benwys/PCB-kondycjonowanie/README.md

# PCB-kondycjonowanie
Projekt układu kondycjonowania sygnałów pomiarowych dla falownika napięcia
