benwys/PCB-kondycjonowanie/331811.brd

## EAGLE design 331811.brd (2026-05-14)

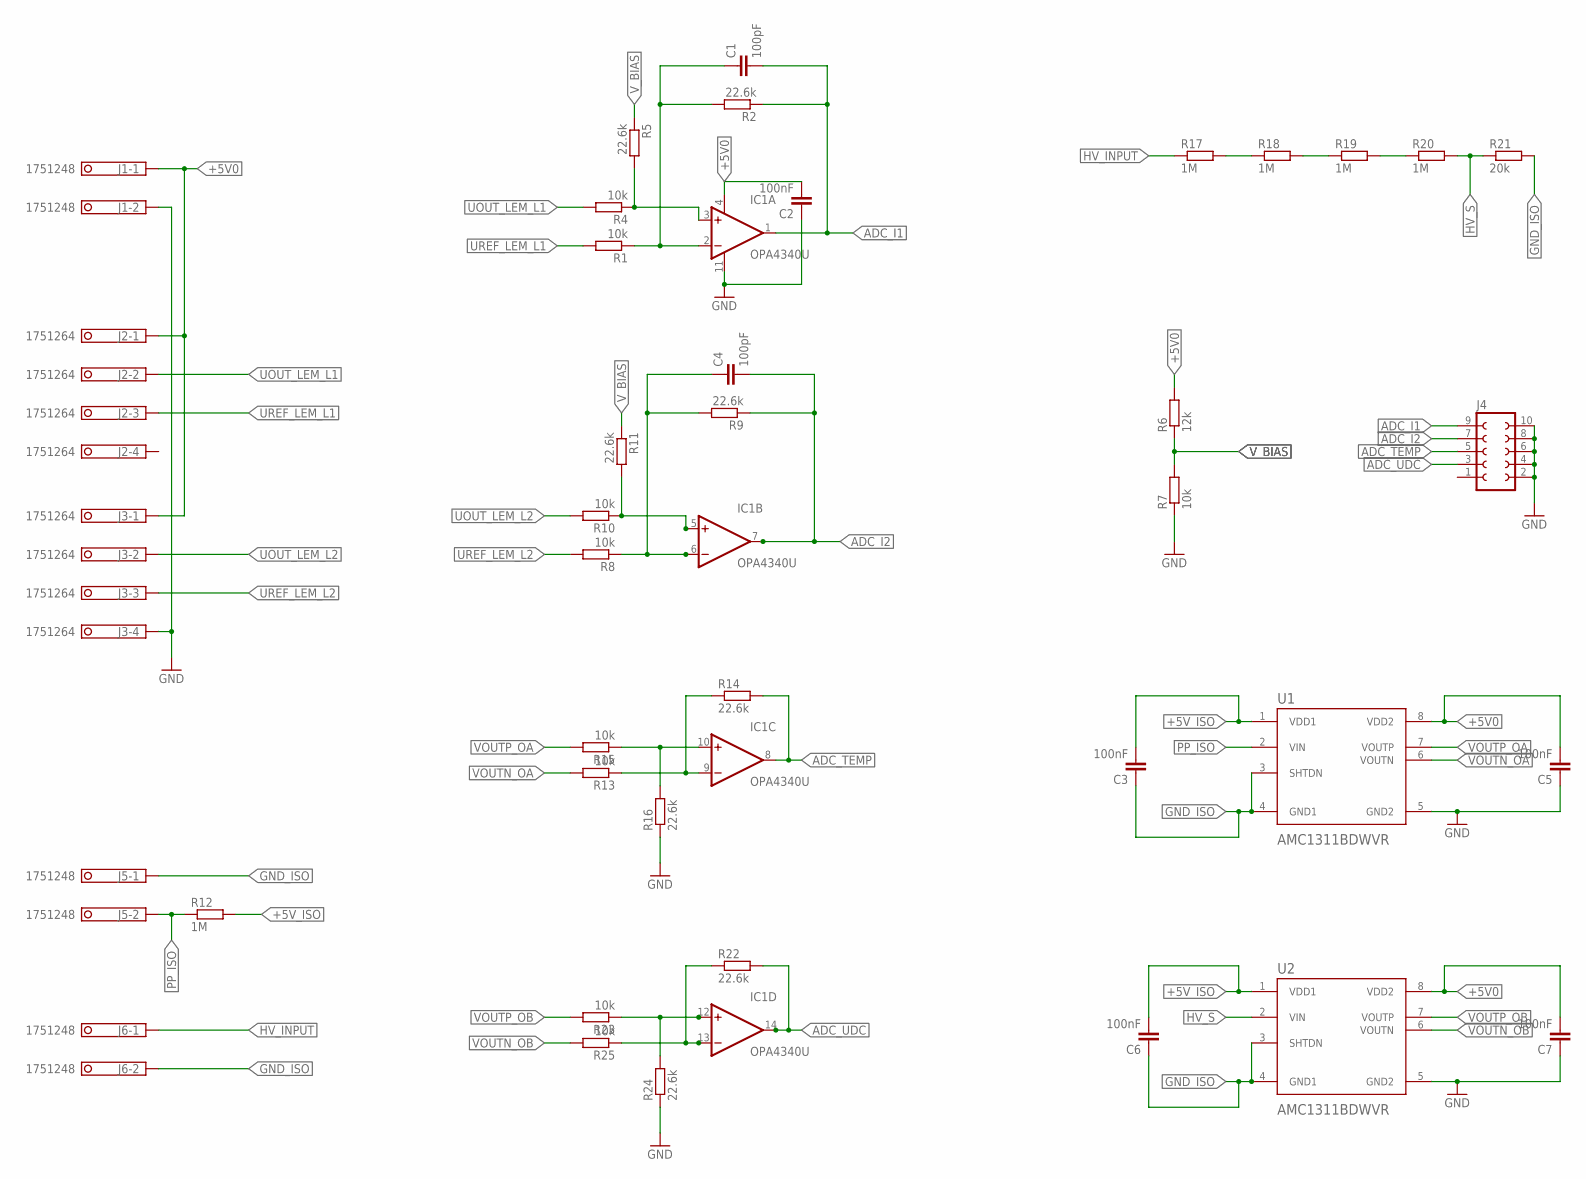
[picture p8: schematic 331811.sch]

Parts:
C1, C4: 100pF; C0805
C2, C3, C5, C6, C7: 100nF; C0805
IC1: OPA4340U; SO14
J1, J5, J6: 1751248
J2, J3: 1751264
J4: FE05-2
R1, R4, R7, R8, R10, R13, R15, R23, R25: 10k; M1206
R2, R5, R9, R11, R14, R16, R22, R24: 22.6k; M1206
R6: 12k; M1206
R12, R17, R18, R19, R20: 1M; M1206
R21: 20k; M1206
U1, U2: AMC1311BDWVR; SOIC127P1150X280-8N

Connections:
+5V0: C2.2, C5.2, C7.2, IC1.4 (V+), J1.1, J2.1, J3.1, R6.2, U1.8 (VDD2), U2.8 (VDD2)
+5V_ISO: C3.2, C6.2, R12.2, U1.1 (VDD1), U2.1 (VDD1)
ADC_I1: C1.2, IC1.1 (OUT), J4.9, R2.1
ADC_I2: C4.2, IC1.7 (OUT), J4.7, R9.1
ADC_TEMP: IC1.8 (OUT), J4.5, R14.2
ADC_UDC: IC1.14 (OUT), J4.3, R22.2
GND: C2.1, C5.1, C7.1, IC1.11 (V-), J1.2, J3.4, J4.2, J4.4, J4.6, J4.8, J4.10, R7.1, R16.1, R24.1, U1.5 (GND2), U2.5 (GND2)
GND_ISO: C3.1, C6.1, J5.1, J6.2, R21.2, U1.3 (SHTDN), U1.4 (GND1), U2.3 (SHTDN), U2.4 (GND1)
HV_INPUT: J6.1, R17.1
HV_S: R20.2, R21.1, U2.2 (VIN)
unnamed: C4.1, IC1.6 (-IN), R8.1, R9.2
unnamed: IC1.5 (+IN), R10.1, R11.2
unnamed: C1.1, IC1.2 (-IN), R1.1, R2.2
unnamed: IC1.9 (-IN), R13.1, R14.1
unnamed: IC1.3 (+IN), R4.1, R5.2
unnamed: IC1.10 (+IN), R15.1, R16.2
unnamed: R17.2, R18.1
unnamed: R18.2, R19.1
unnamed: R19.2, R20.1
unnamed: IC1.13 (-IN), R22.1, R25.1
unnamed: IC1.12 (+IN), R23.1, R24.2
PP_ISO: J5.2, R12.1, U1.2 (VIN)
UOUT_LEM_L1: J2.2
UOUT_LEM_L2: J3.2
UREF_LEM_L1: J2.3, R1.2
UREF_LEM_L2: J3.3, R8.2
VOUTN_OA: R13.2, U1.6 (VOUTN)
VOUTN_OB: R25.2, U2.6 (VOUTN)
VOUTP_OA: R15.2, U1.7 (VOUTP)
VOUTP_OB: R23.2, U2.7 (VOUTP)
V_BIAS: R5.1, R6.1, R7.2, R11.1

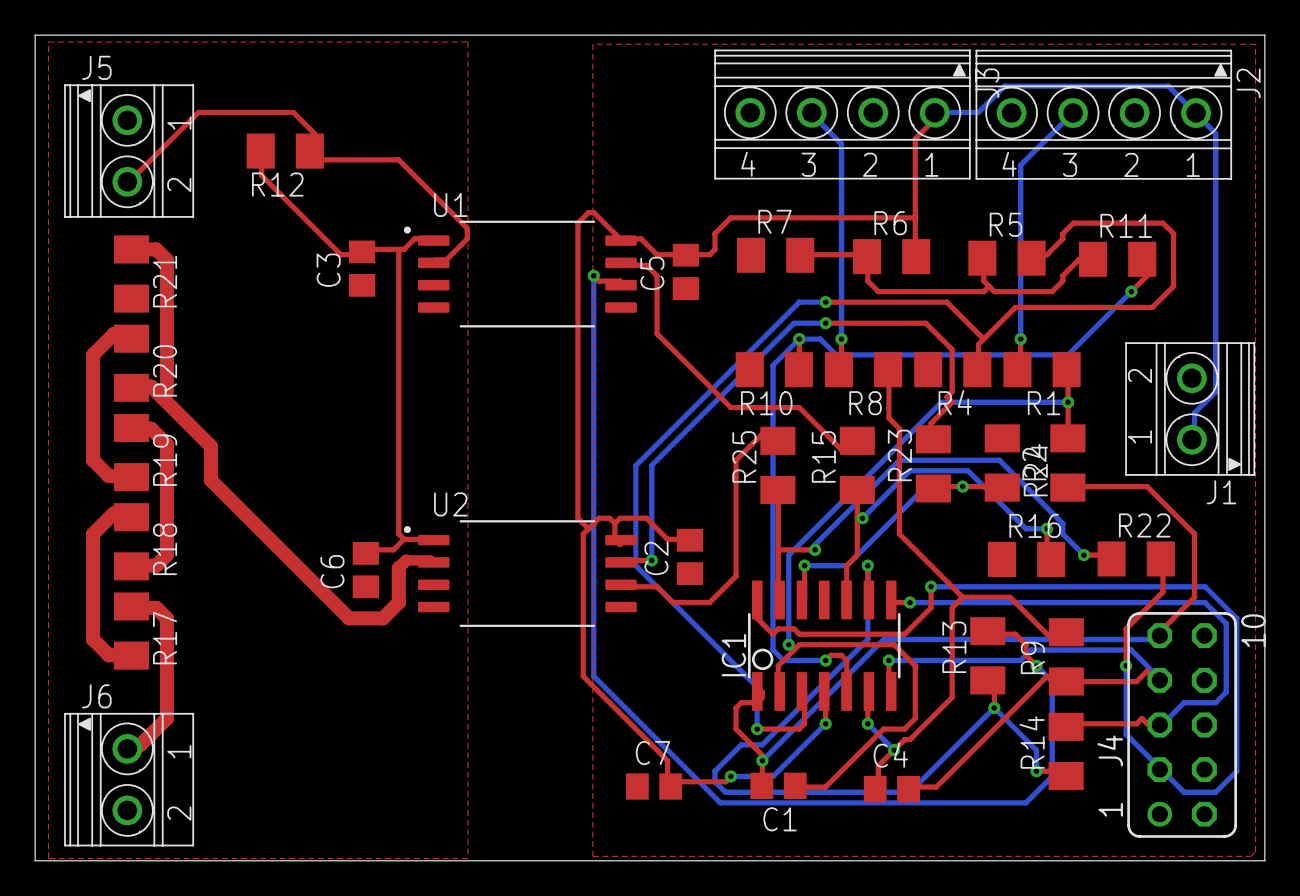
[picture p9: board 331811.brd from above]

Board: 2 copper layers, 70.0 x 47.0 mm, 40 parts (0 on the bottom side), 29 nets.
